pchretien/quaternary/Base4 Clock Color Palettes.pdf

# Color Palettes Descriptions

The following table lists all the color palettes available in the Base4Clock. Press the RED button to toggle from one color palette to the next one.

# | NAME | HOUR | MINUTES | BOTH

1 RGB

2 MONDRIAN

3 BASBRUN

4 80’S

5 PASTEL

6 MODERN

7 COLD

8 WARM

9 EARTH

10 DARK
