pchretien/quaternary/(list of files, cad)

Other CAD files:
base4_cnc_eploded.skp
