pchretien/quaternary/(list of files, drawings)

Other design files:
base4.fzz
