pchretien/quaternary/Base4 Clock Assembly Instructions.pdf

# Base4 Clock Assembly Instructions

# #Build

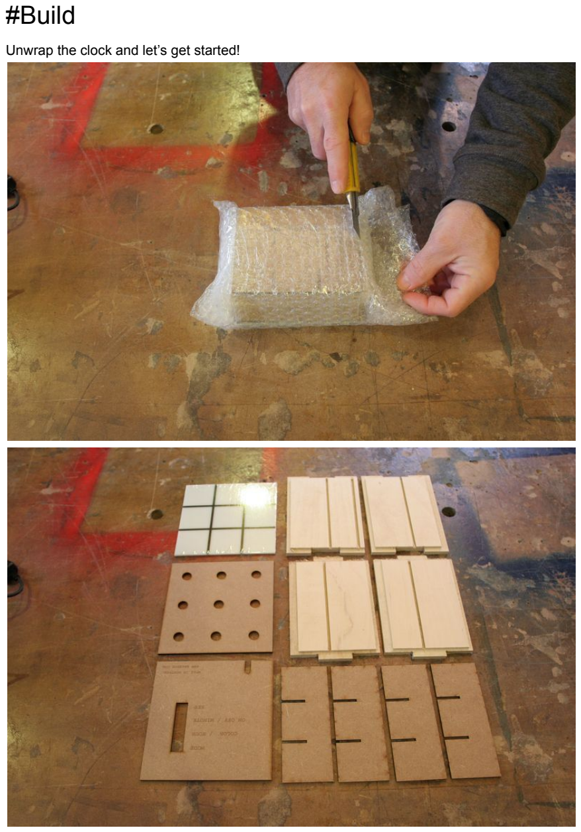
[picture p1: page 2]

Unwrap the clock and let’s get started!

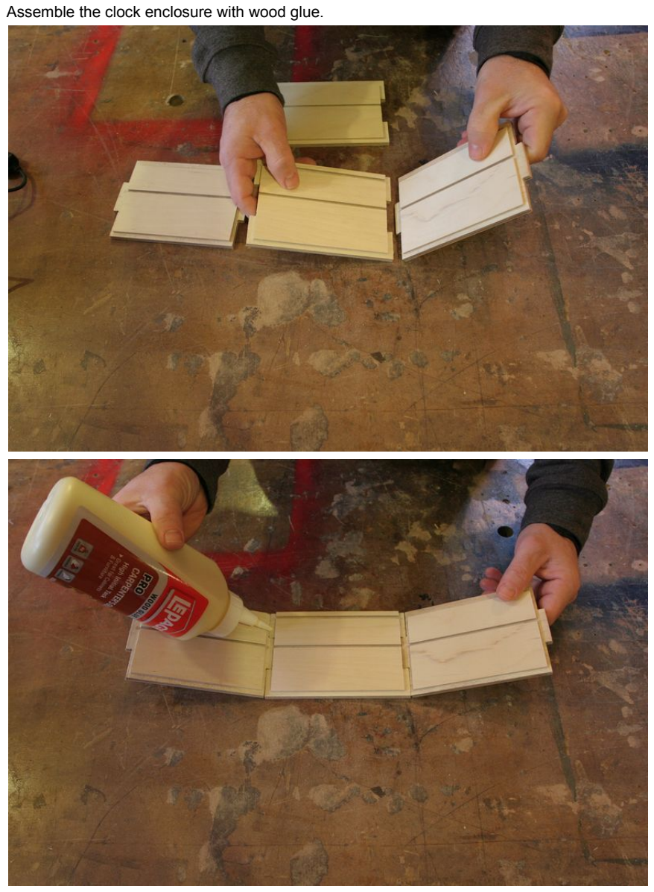
[picture p2: page 3]

Assemble the clock enclosure with wood glue.

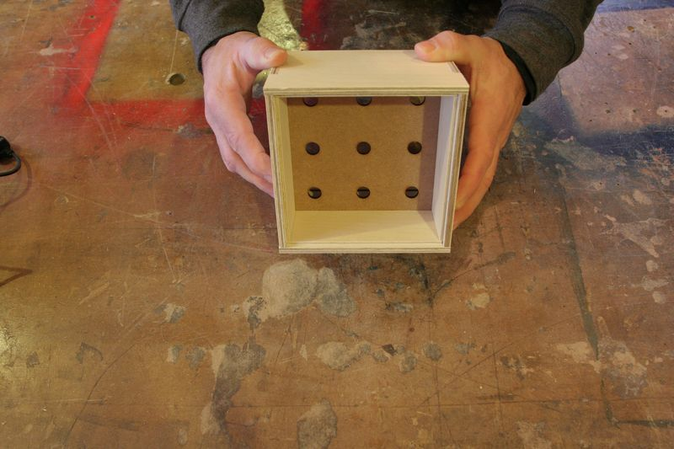
[picture p3: figure]

It’s now time to sand the exterior of the clock and apply the finish of your choice. I would recommend sanding up to 220 and applying one coat of spray lacquer.

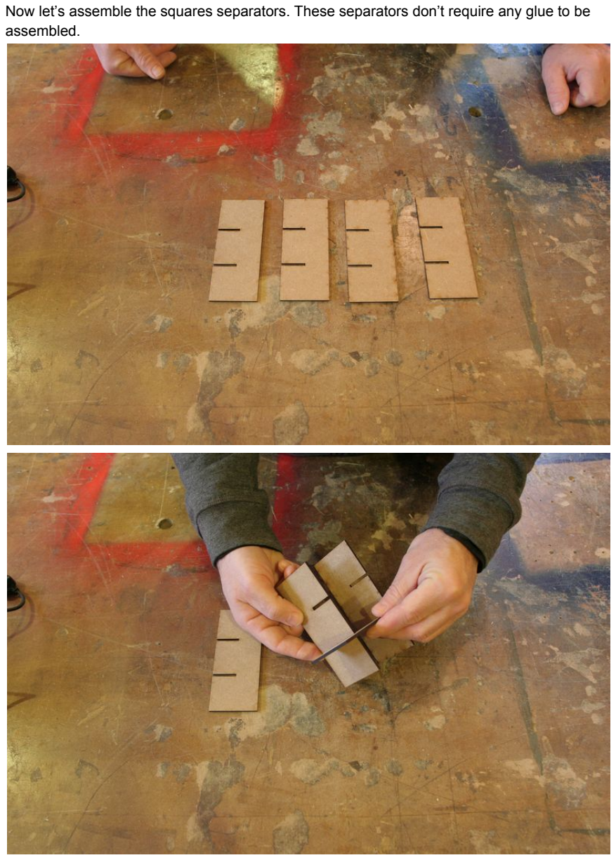
[picture p4: page 5]

N

o

w le

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
s. T

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
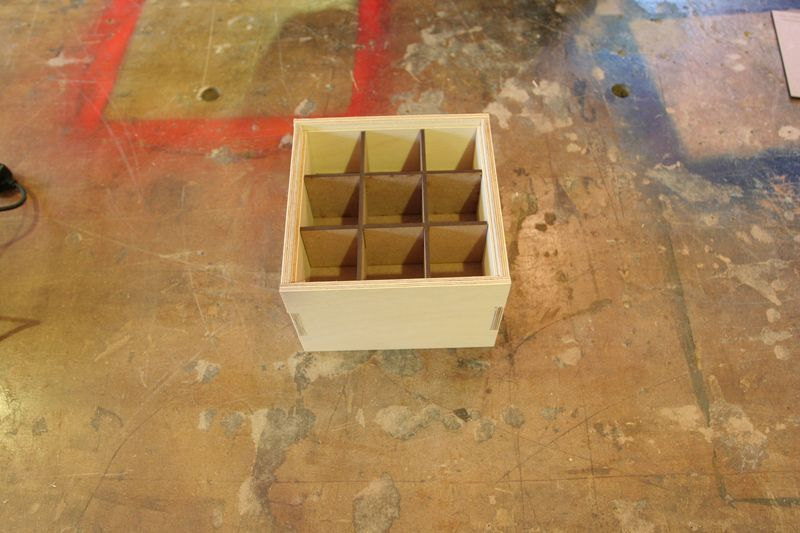
[picture p5: figure]
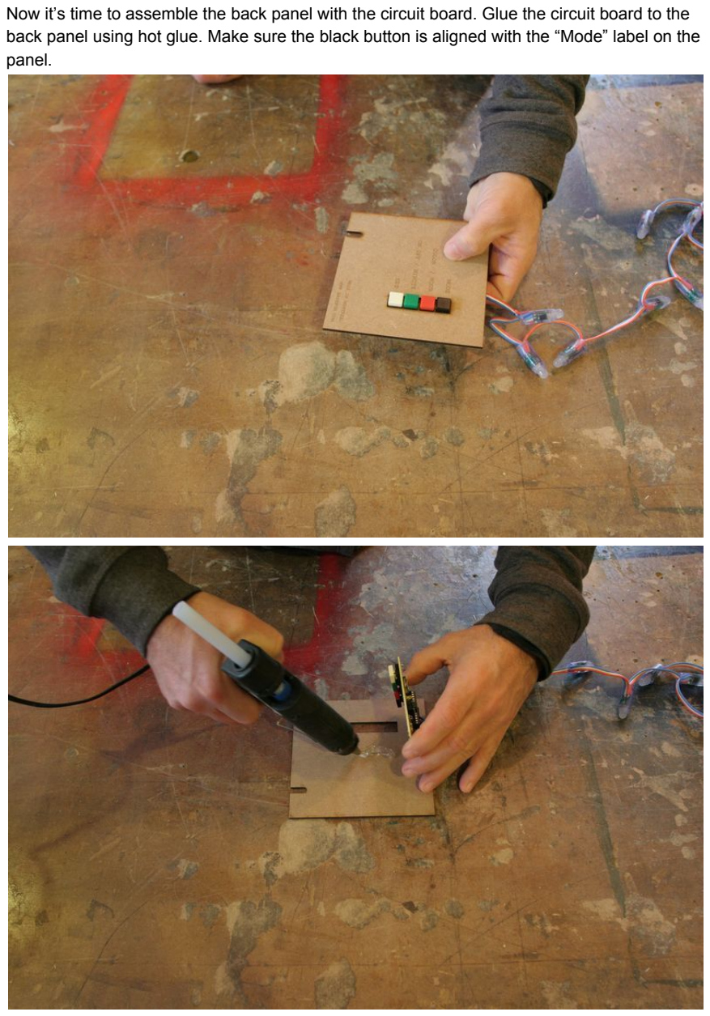
[picture p6: page 7]

Now it’s time to assemble the back panel with the circuit board. Glue the circuit board to the back panel using hot glue. Make sure the black button is aligned with the “Mode” label on the panel.

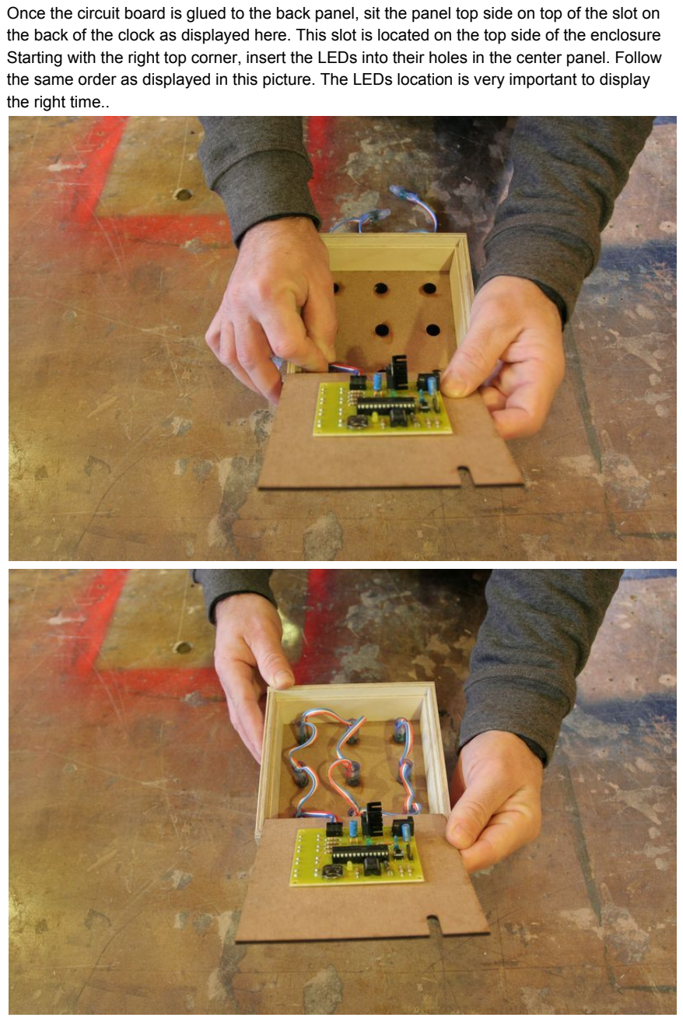
[picture p7: page 8]

Once the circuit board is glued to the back panel, sit the panel top side on top of the slot on the back of the clock as displayed here. This slot is located on the top side of the enclosure Starting with the right top corner, insert the LEDs into their holes in the center panel. Follow the same order as displayed in this picture. The LEDs location is very important to display the right time..

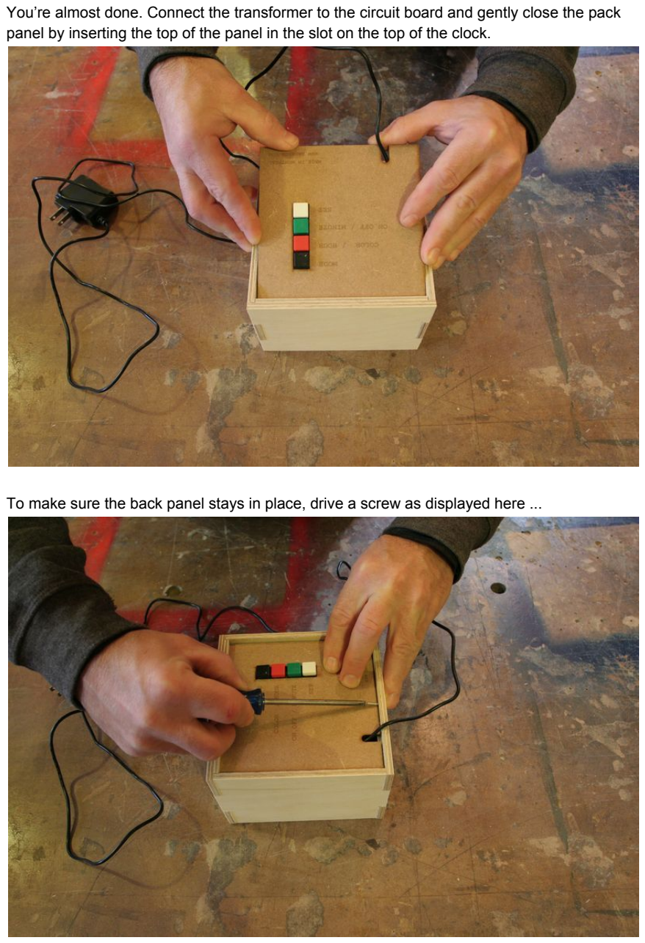
[picture p8: page 9]

You’re almost done. Connect the transformer to the circuit board and gently close the pack panel by inserting the top of the panel in the slot on the top of the clock.

To make sure the back panel stays in place, drive a screw as displayed here ...

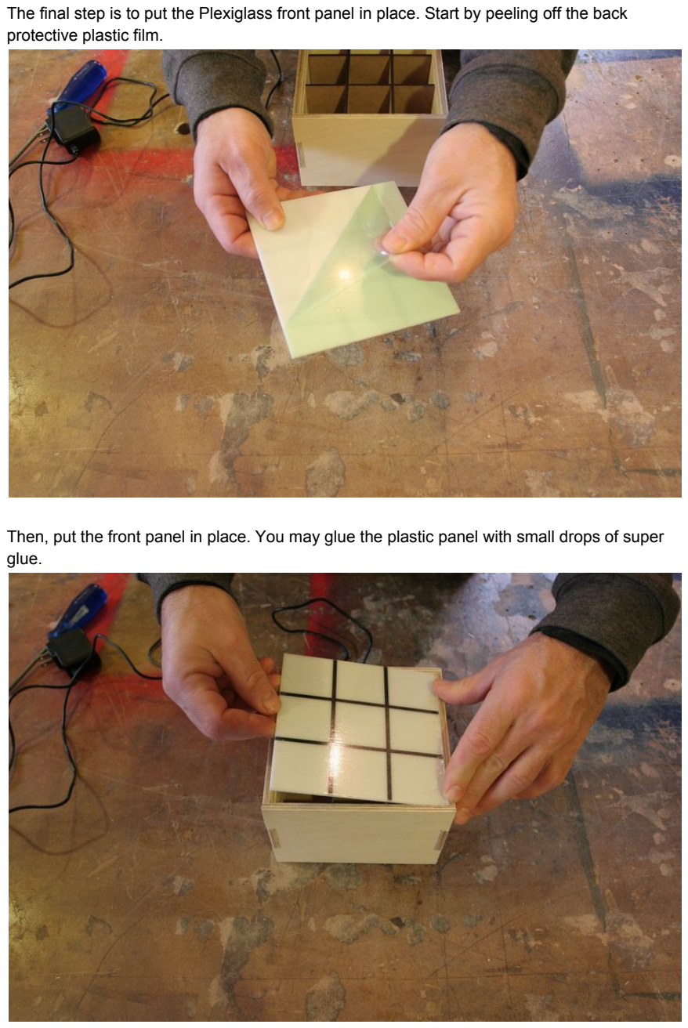
[picture p9: page 10]

The final step is to put the Plexiglass front panel in place. Start by peeling off the back protective plastic film.

Then, put the front panel in place. You may glue the plastic panel with small drops of super glue.

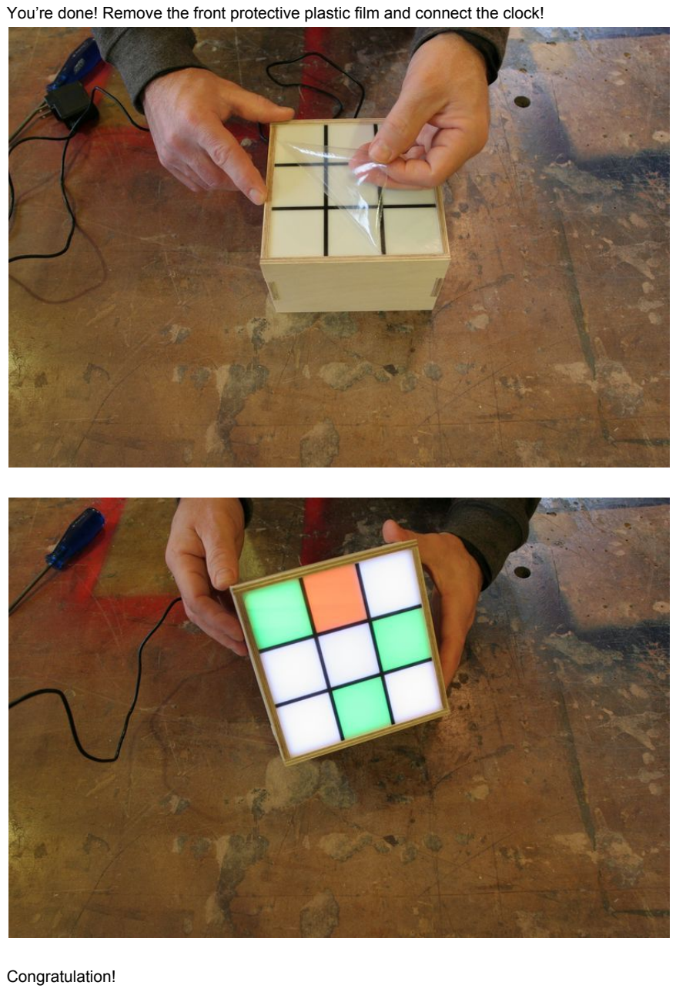
[picture p10: page 11]

You’re done! Remove the front protective plastic film and connect the clock!

Congratulation!

# #Share

I would love to see your clock! Please share pictures of your clock with #base4clock on Facebook, Twitter and Instagram!

Visit me on Facebook, Instagram and Twitter!

Thank you for supporting my project!

Philippe
