pchretien/quaternary/(commit log)

2017-10-26 Sent the PCB for production
    [base4.fzz, base4.skp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]
2017-11-06 Finished first proto on CNC
    [base4.skp, base4_cnc_eploded.skp]
2017-11-17 Final drawings for CNC ans Laser production
    [base4_cnc_eploded.skp, base4_cnc_eploded_plexi.dwg, base4_cnc_eploded_plexi_cugt.2010.dwg, base4_cnc_eploded_plexi_cugt.dwg, base4_cnc_eploded_separator.2010.dwg, base4_cnc_eploded_separator.dwg, base4_cnc_exploded_back_middle.2010.dwg, base4_cnc_exploded_back_middle.dwg]
2018-07-05 Updated the diagnostic mode to return error code without LEDs attached
    [base4_cnc_eploded.skp, base4_cnc_eploded_plexi.dwg, base4_cnc_eploded_plexi_cugt.2010.dwg, base4_cnc_eploded_plexi_cugt.dwg, base4_cnc_eploded_separator.2010.dwg, base4_cnc_eploded_separator.dwg, base4_cnc_exploded_back_middle.2010.dwg, base4_cnc_exploded_back_middle.dwg]
