pchretien/quaternary/(notices)

Notices in the files:
base4.ino:
modify it under the terms of the GNU General Public License Version 2
